Ahkdel/WirelessRobotArm/Photos/IMG_20210429_025416.jpg

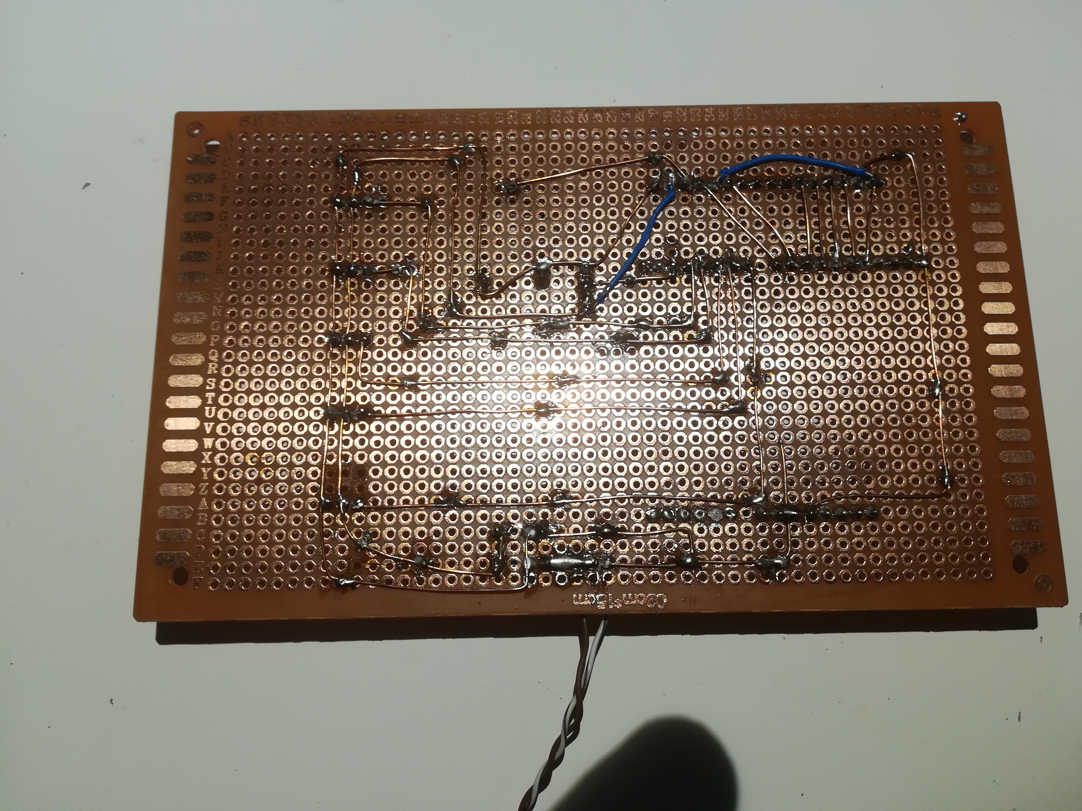
Photos/IMG_20210429_025416.jpg
