Ahkdel/WirelessRobotArm/Robot+Gripper+MG90S+/images/card_preview_gripper_v2.PNG

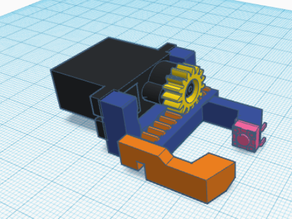
Robot+Gripper+MG90S+/images/card_preview_gripper_v2.PNG
