Ahkdel/WirelessRobotArm/Circuits/receiver circuit.BMP

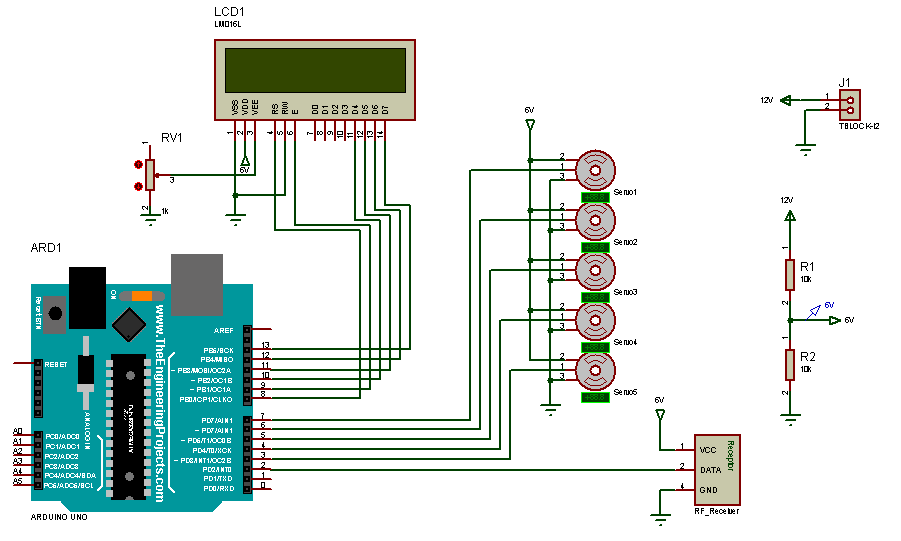
Circuits/receiver circuit.BMP
