Ahkdel/WirelessRobotArm/dan robot arm/images/0ae6d6eee16928dc33c345dd7e37c0fc_preview_featured.jpg

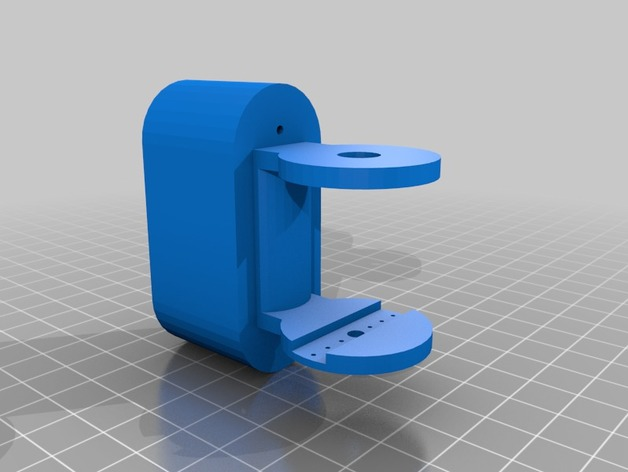
dan robot arm/images/0ae6d6eee16928dc33c345dd7e37c0fc_preview_featured.jpg
