Ahkdel/WirelessRobotArm/dan robot arm/images/57f312213586f4db5ce062b65d8a6737_preview_featured.jpg

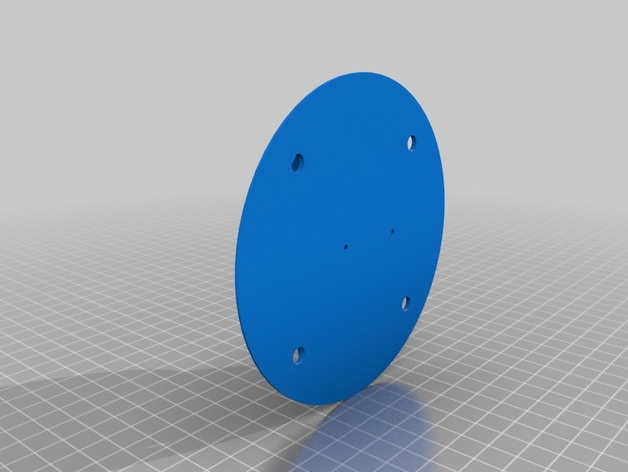
dan robot arm/images/57f312213586f4db5ce062b65d8a6737_preview_featured.jpg
