Ahkdel/WirelessRobotArm/dan robot arm/images/775567f67922da70272757af8e796da0_preview_featured.jpg

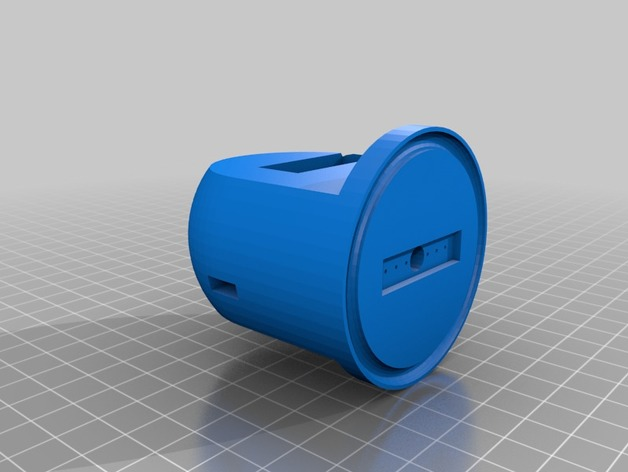
dan robot arm/images/775567f67922da70272757af8e796da0_preview_featured.jpg
