Ahkdel/WirelessRobotArm/dan robot arm/images/b43055eece1fc8d2b7b2e10ad4672d2d_preview_featured.jpg

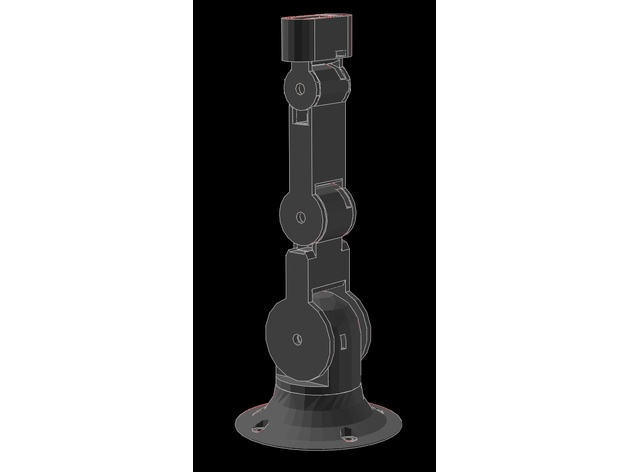
dan robot arm/images/b43055eece1fc8d2b7b2e10ad4672d2d_preview_featured.jpg
