Ahkdel/WirelessRobotArm/Diagramas/Diagrama de bloques3.png

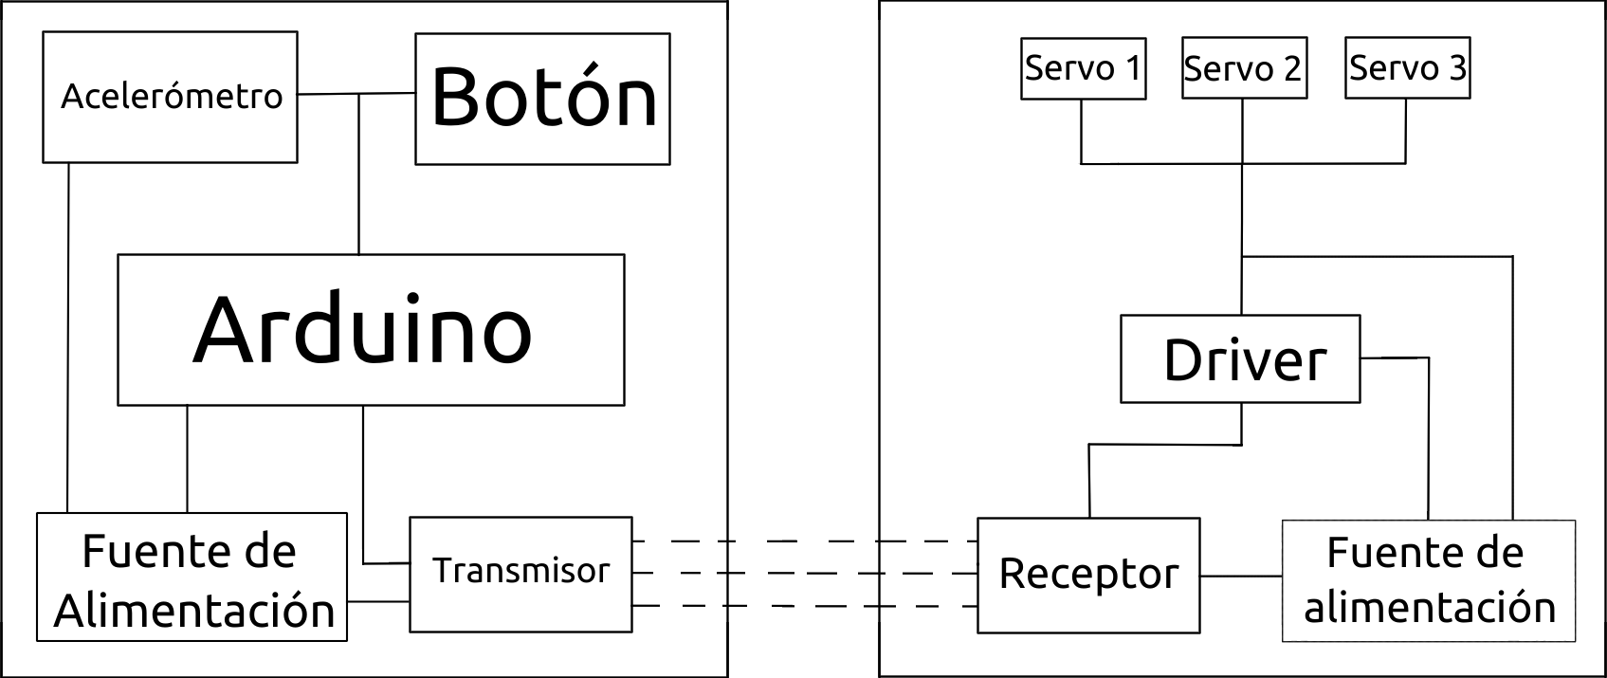
Diagramas/Diagrama de bloques3.png
