Ahkdel/WirelessRobotArm/Diagramas/Diagrama de bloques.png

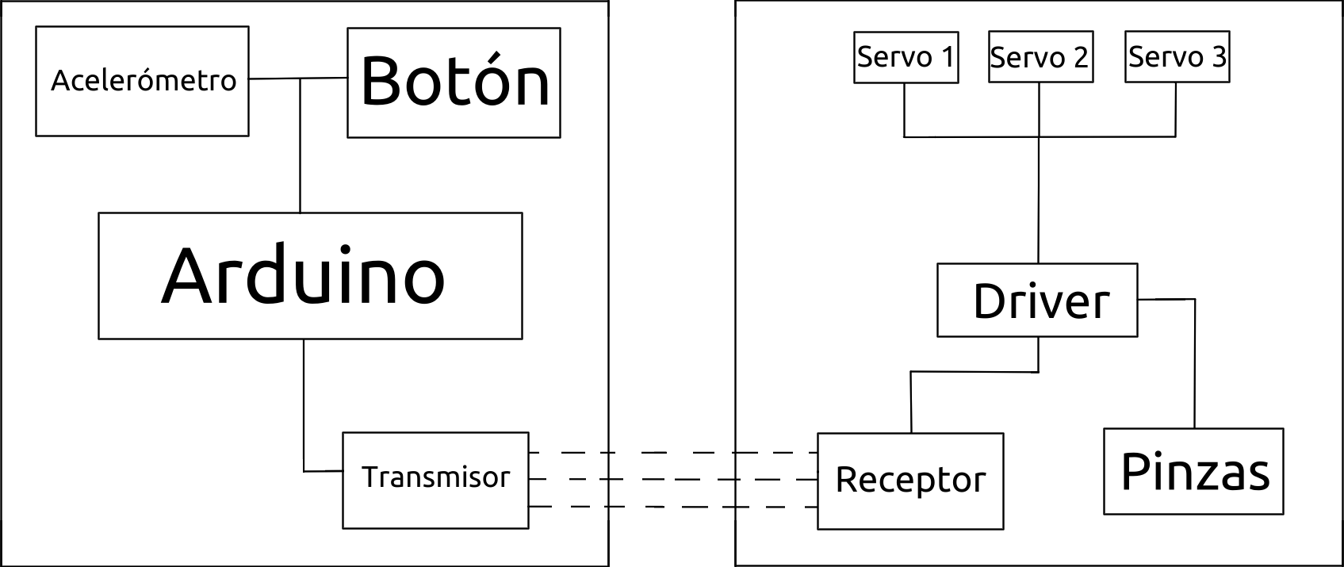
Diagramas/Diagrama de bloques.png
