Ahkdel/WirelessRobotArm/Photos/IMG_20210429_025436.jpg

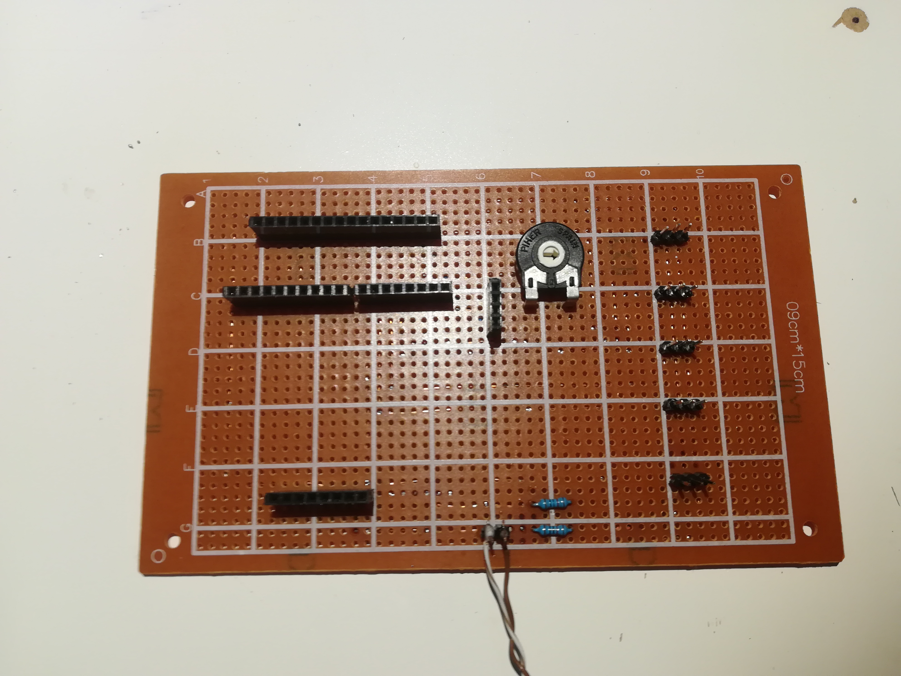
Photos/IMG_20210429_025436.jpg
