Ahkdel/WirelessRobotArm/Photos/IMG_20210430_110134.jpg

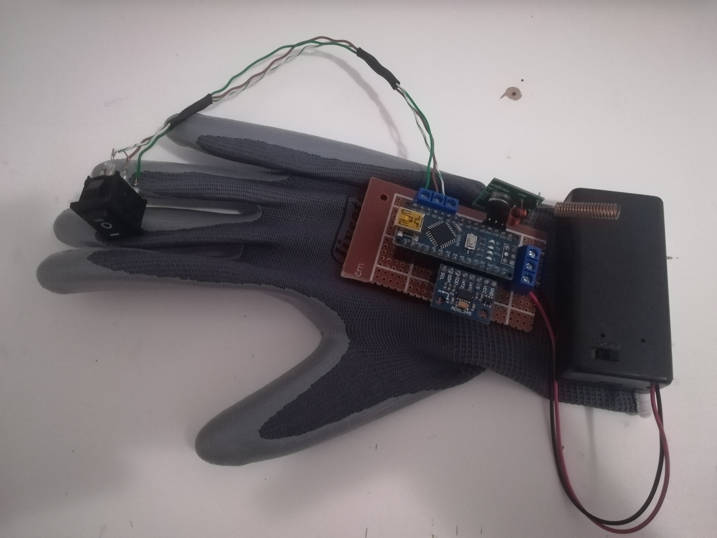
Photos/IMG_20210430_110134.jpg
