Ahkdel/WirelessRobotArm/Photos/IMG_20210430_110211.jpg

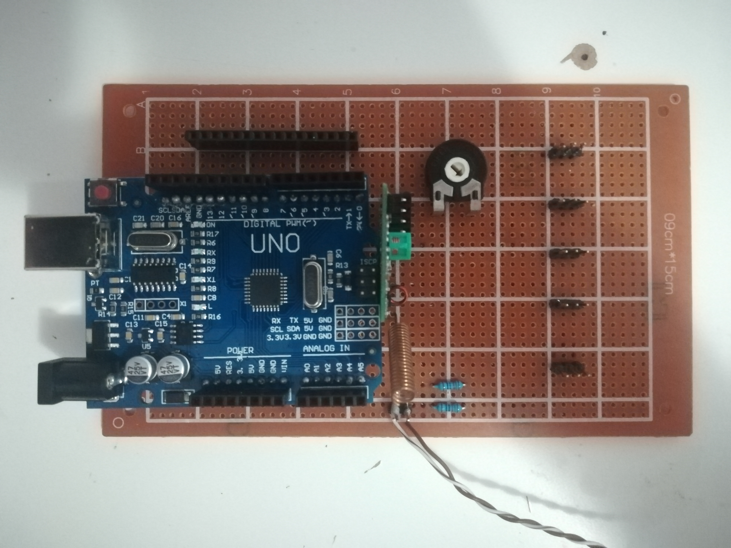
Photos/IMG_20210430_110211.jpg
