Ahkdel/WirelessRobotArm/Photos/IMG_20210430_110328.jpg

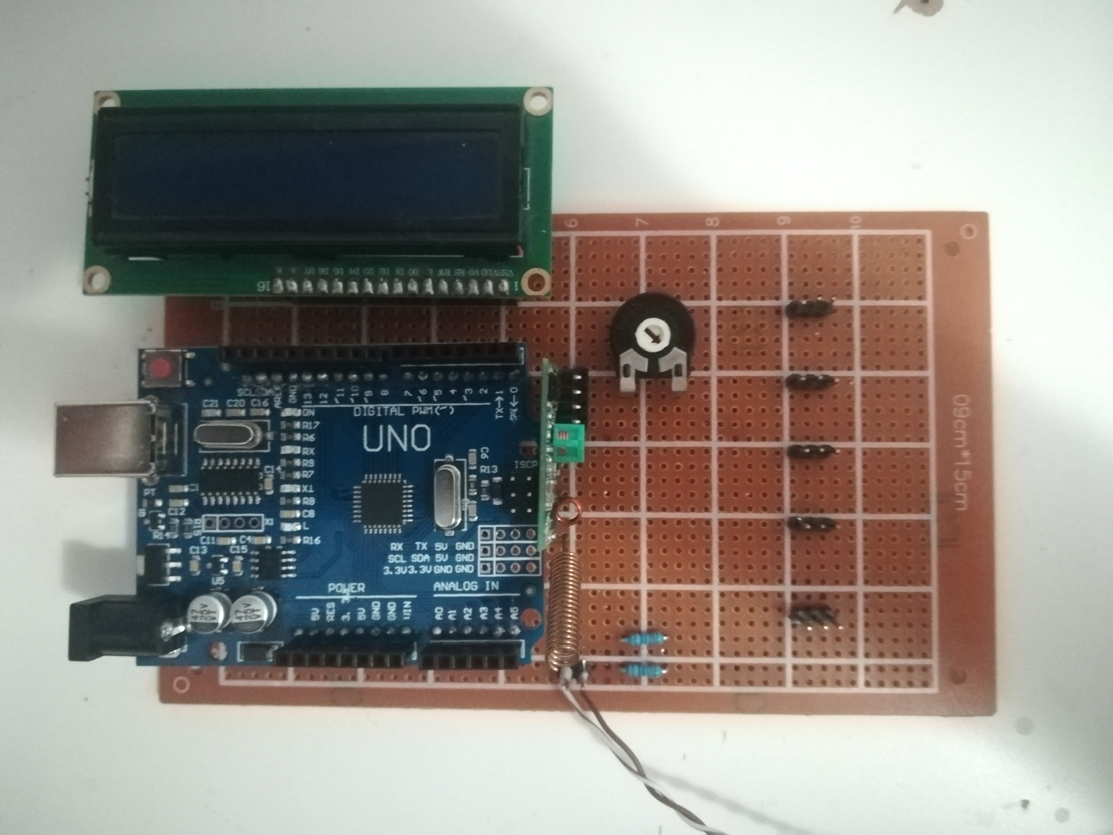
Photos/IMG_20210430_110328.jpg
