Ahkdel/WirelessRobotArm/Photos/IMG_20210430_110356.jpg

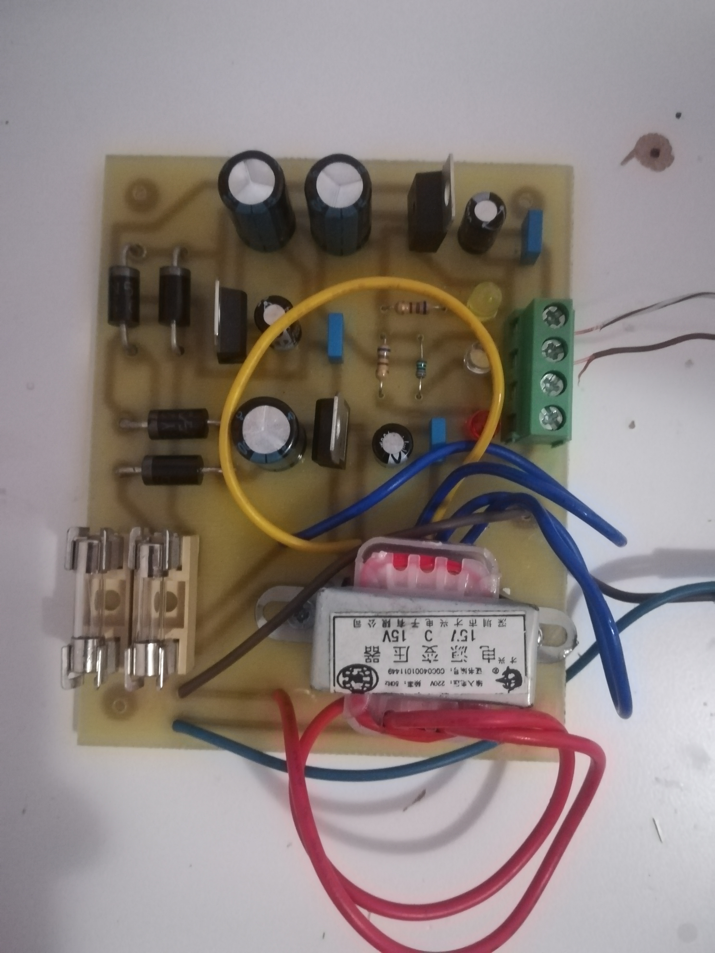
Photos/IMG_20210430_110356.jpg
