Ahkdel/WirelessRobotArm/Photos/IMG_20210430_181212.jpg

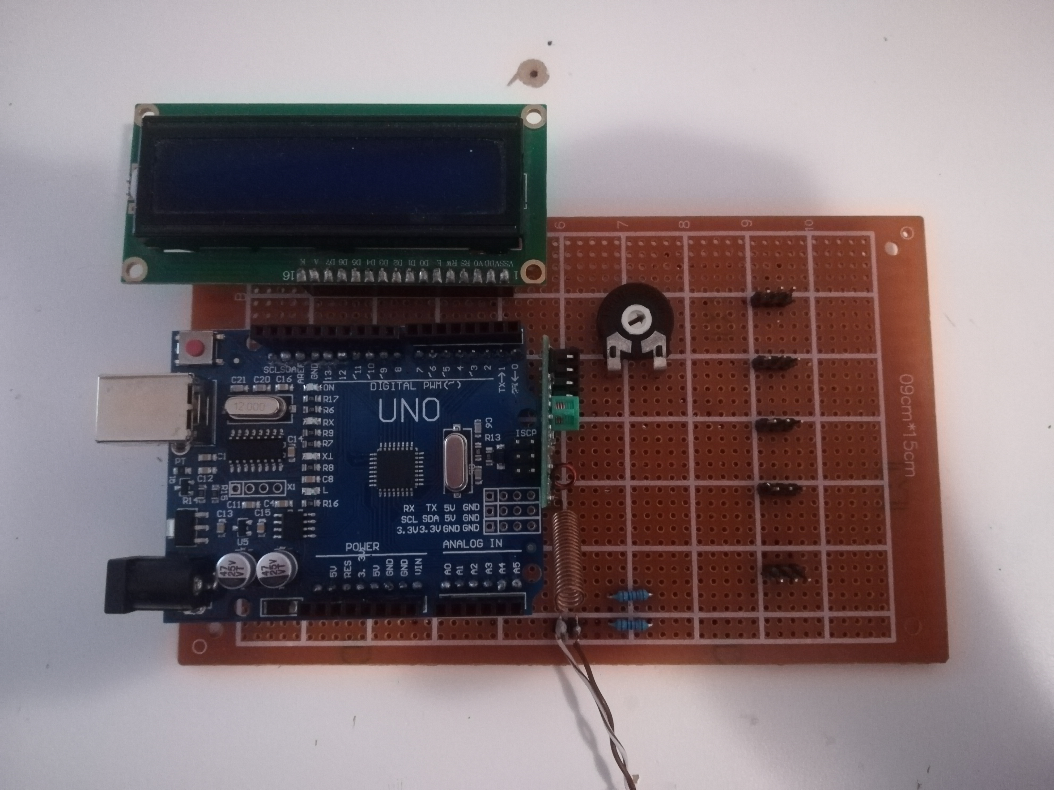
Photos/IMG_20210430_181212.jpg
