Ahkdel/WirelessRobotArm/Photos/IMG_20210430_181712.jpg

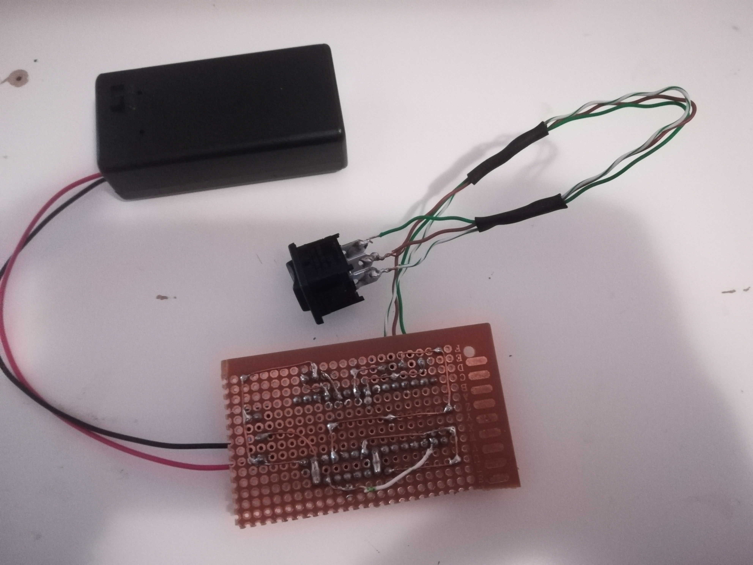
Photos/IMG_20210430_181712.jpg
