Ahkdel/WirelessRobotArm/Photos/IMG_20210430_181934.jpg

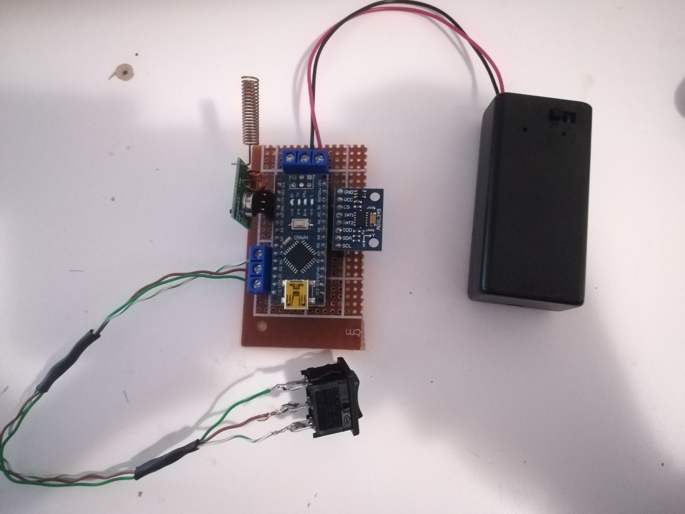
Photos/IMG_20210430_181934.jpg
