Ahkdel/WirelessRobotArm/Photos/IMG_20210430_182728.jpg

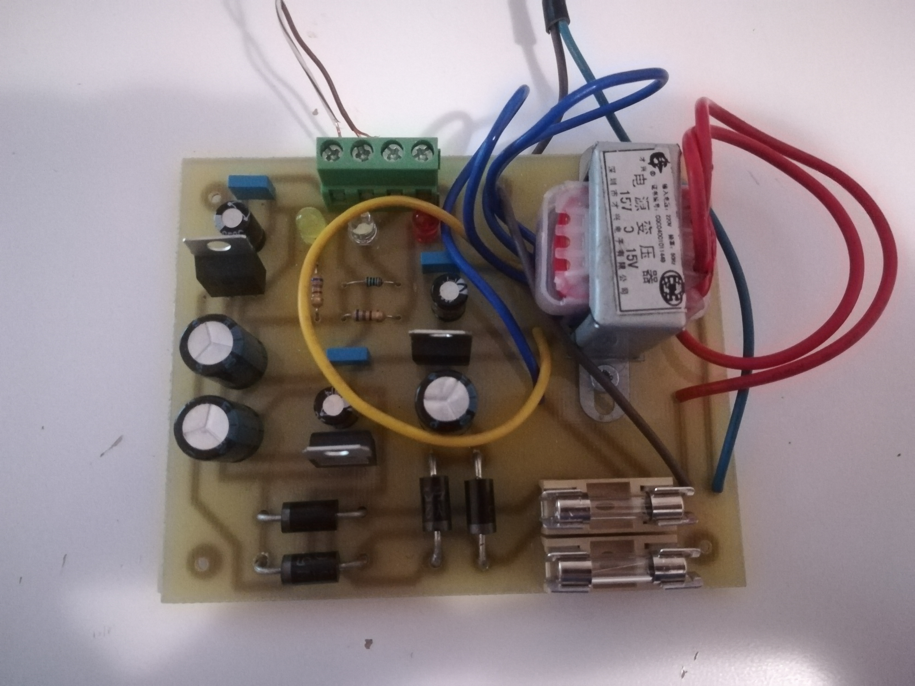
Photos/IMG_20210430_182728.jpg
