Ahkdel/WirelessRobotArm/Photos/IMG_20210430_183803.jpg

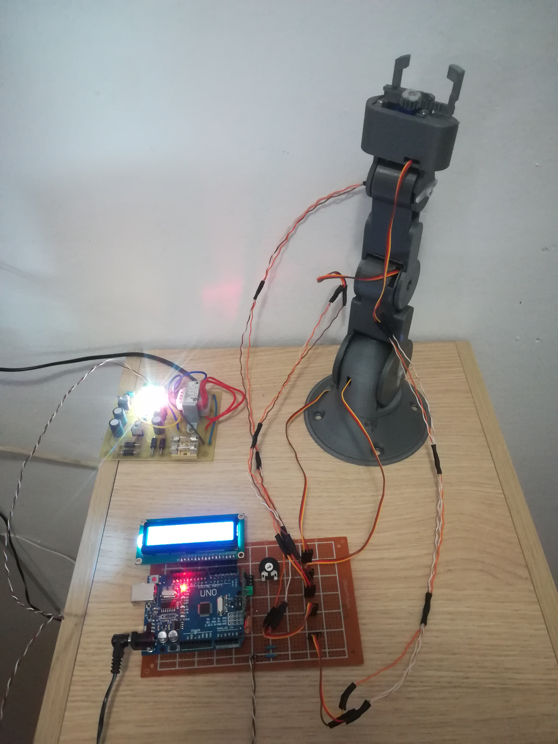
Photos/IMG_20210430_183803.jpg
