Ahkdel/WirelessRobotArm/Photos/IMG_20210430_191755.jpg

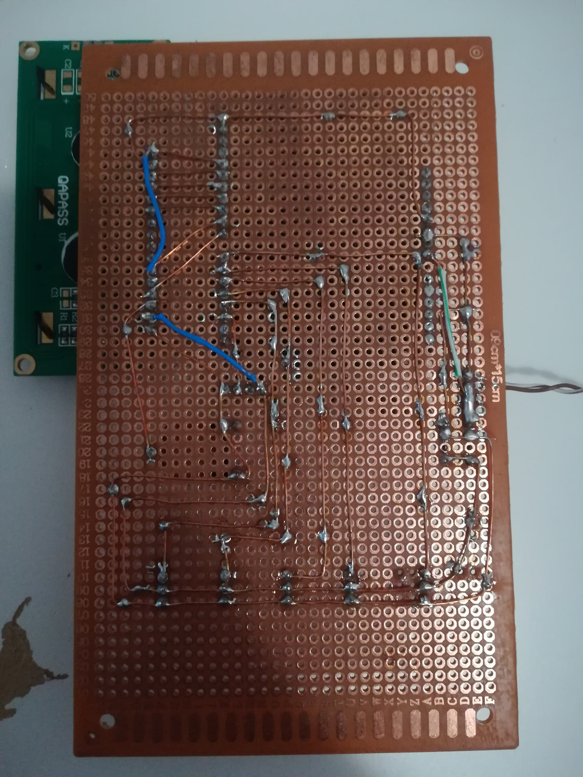
Photos/IMG_20210430_191755.jpg
