Ahkdel/WirelessRobotArm/Photos/Update1/IMG_20210512_164559.jpg

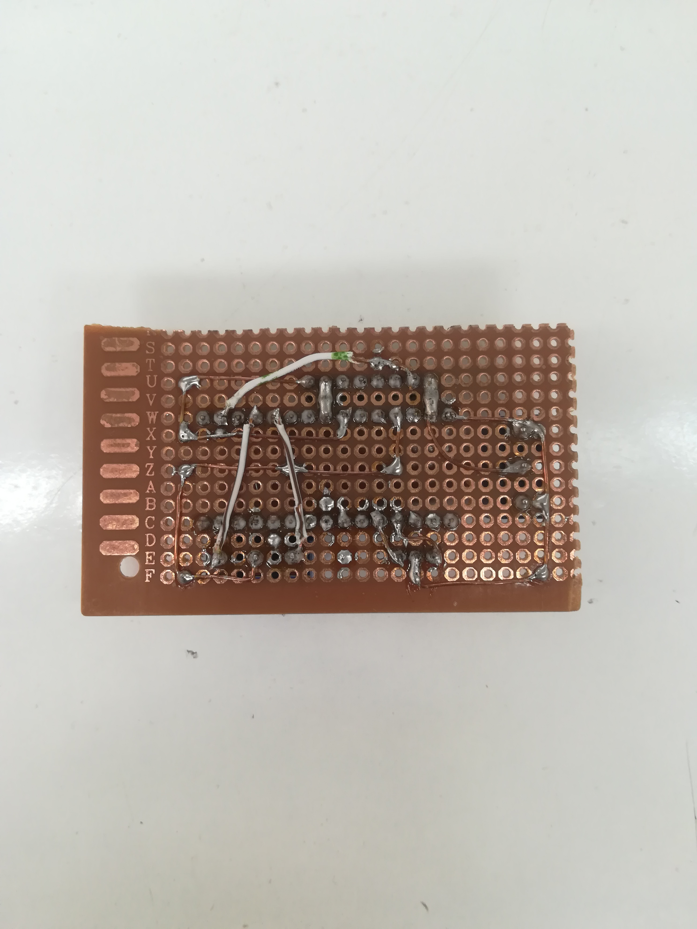
Photos/Update1/IMG_20210512_164559.jpg
