Ahkdel/WirelessRobotArm/Photos/Update1/IMG_20210513_072025.jpg

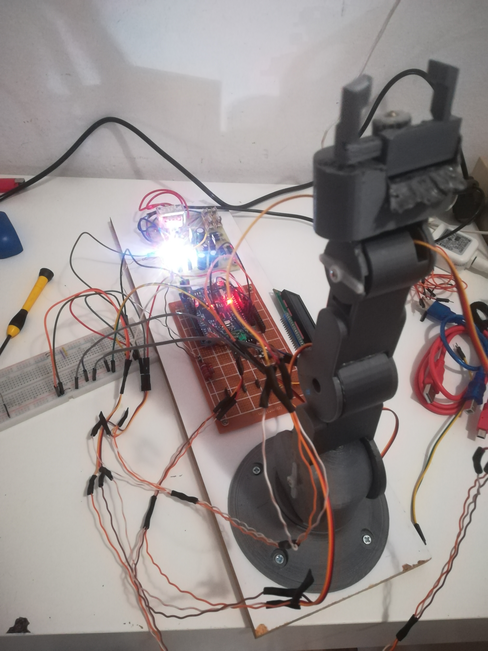
Photos/Update1/IMG_20210513_072025.jpg
