Ahkdel/WirelessRobotArm/Photos/Update1/IMG_20210513_074750.jpg

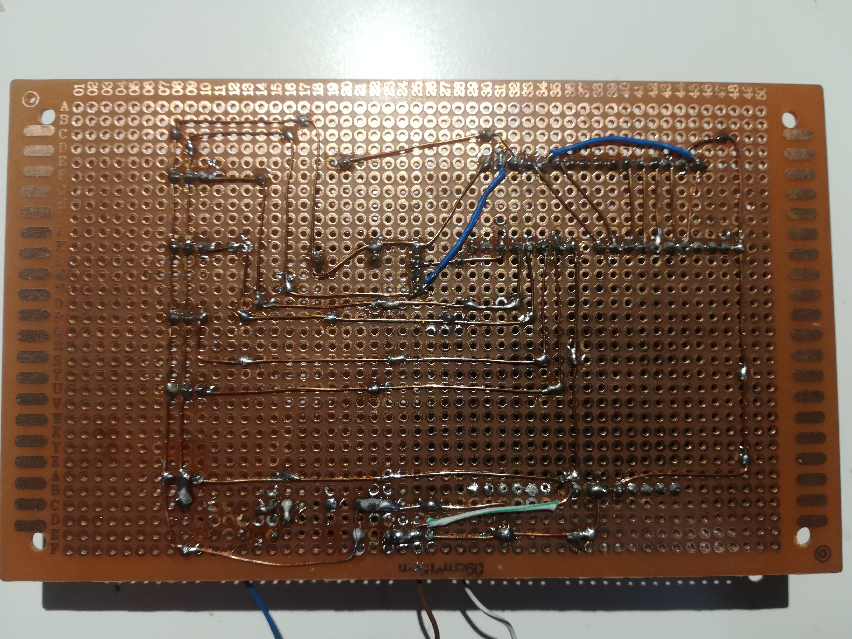
Photos/Update1/IMG_20210513_074750.jpg
