Ahkdel/WirelessRobotArm/Photos/Update1/IMG_20210513_081245.jpg

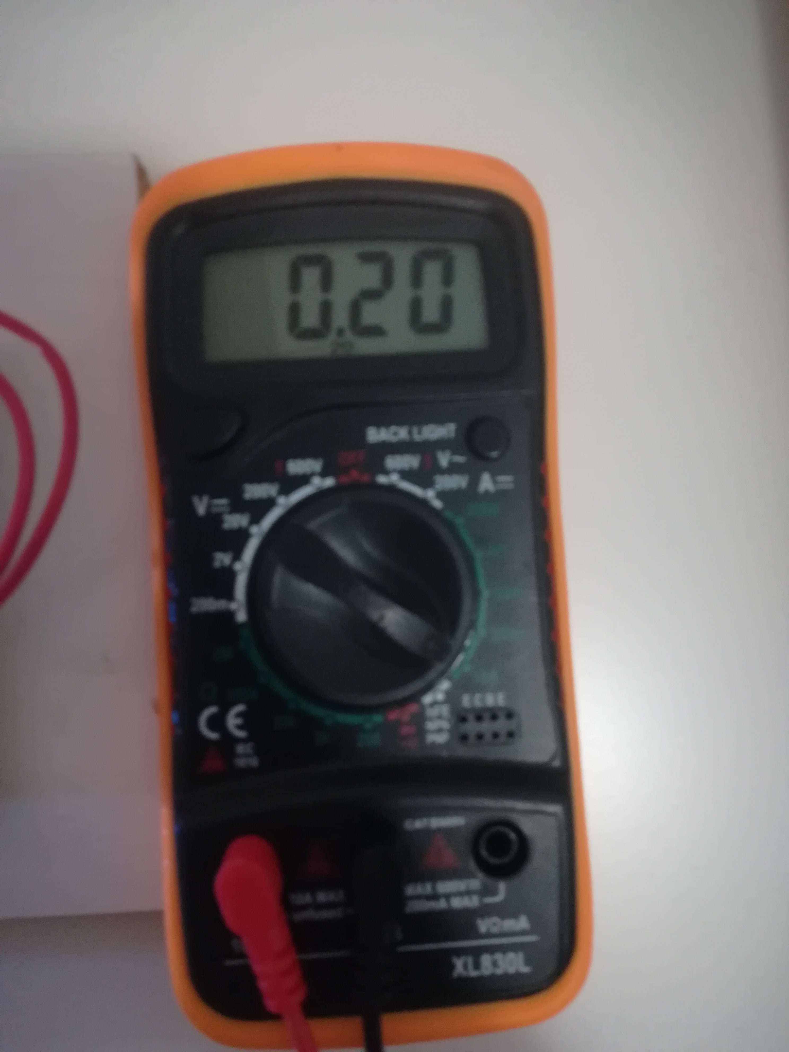
Photos/Update1/IMG_20210513_081245.jpg
