Ahkdel/WirelessRobotArm/Photos/Update1/IMG_20210513_150117.jpg

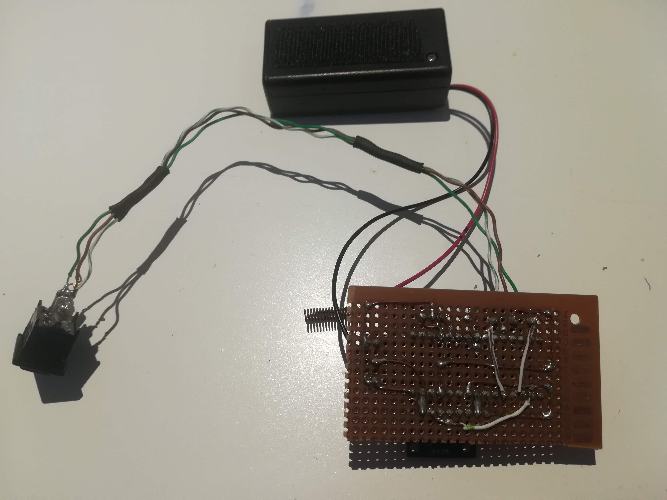
Photos/Update1/IMG_20210513_150117.jpg
