Ahkdel/WirelessRobotArm/Photos/Update1/IMG_20210513_150123.jpg

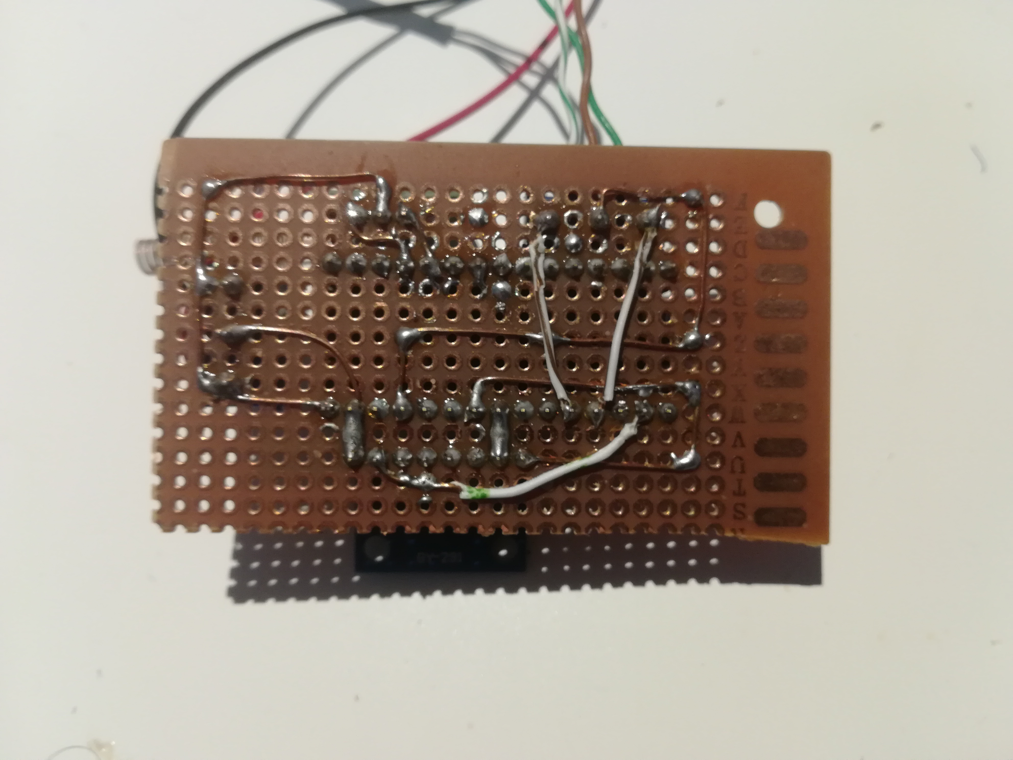
Photos/Update1/IMG_20210513_150123.jpg
