Ahkdel/WirelessRobotArm/references/mg996r.jpg

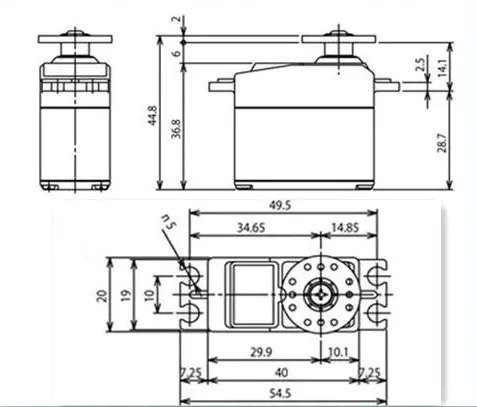
references/mg996r.jpg
