Ahkdel/WirelessRobotArm/references/receiver circuit pcb.BMP

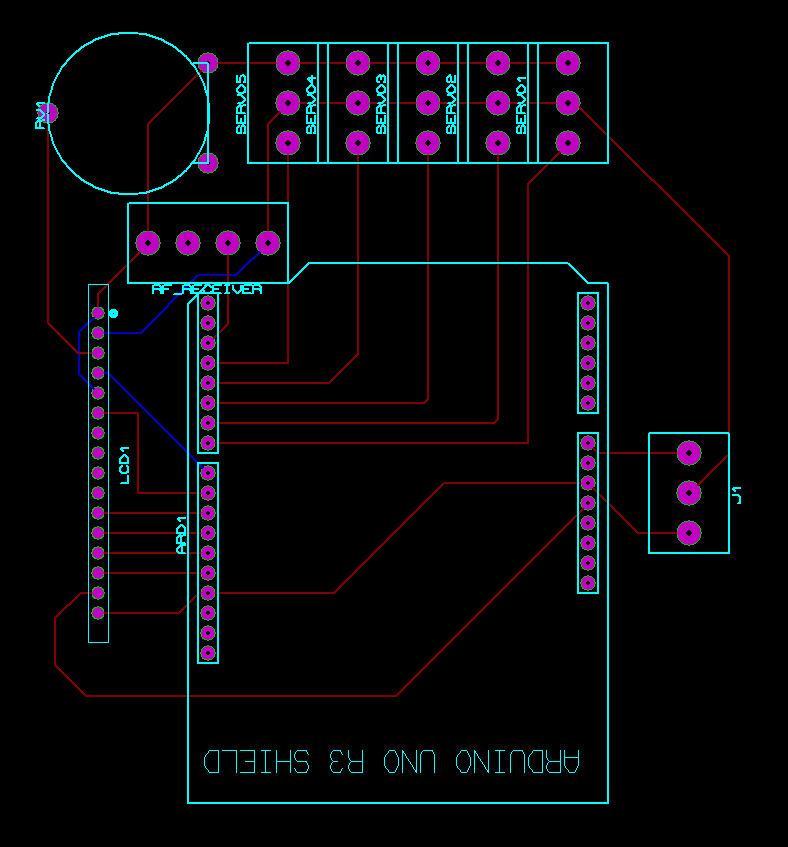
references/receiver circuit pcb.BMP
