Ahkdel/WirelessRobotArm/references/transmitter circuit pcb.BMP

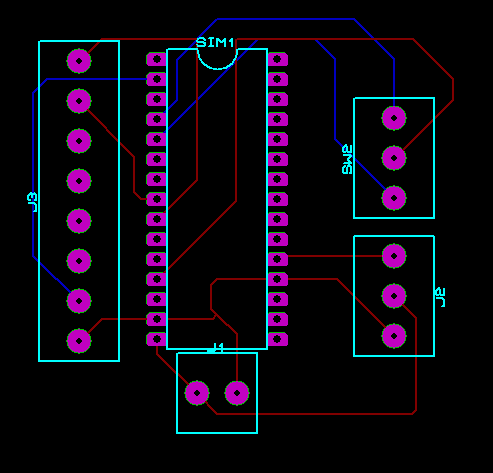
references/transmitter circuit pcb.BMP
