Ahkdel/WirelessRobotArm/references/transmitter circuit.BMP

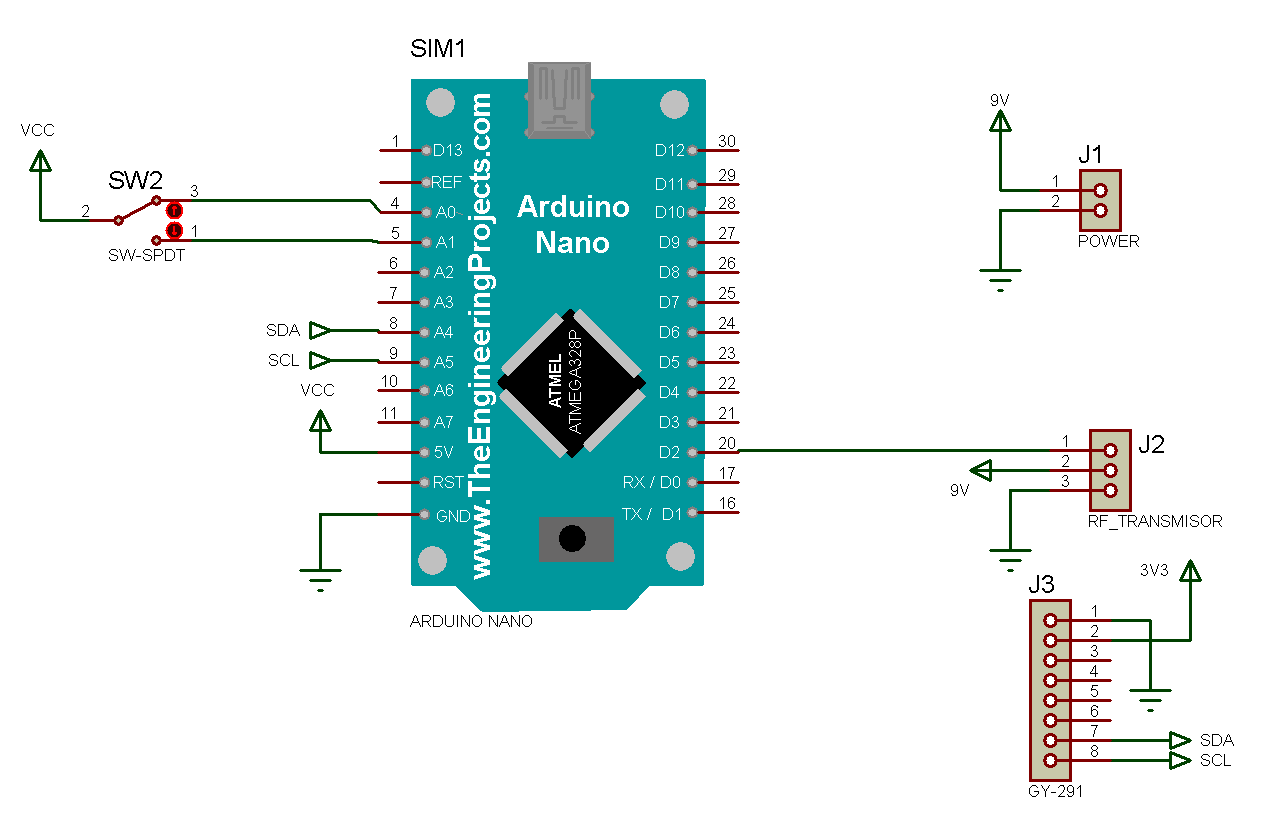
references/transmitter circuit.BMP
