Ahkdel/WirelessRobotArm/Robot+Gripper+MG90S+/images/large_display_IMG_2346[1.JPG

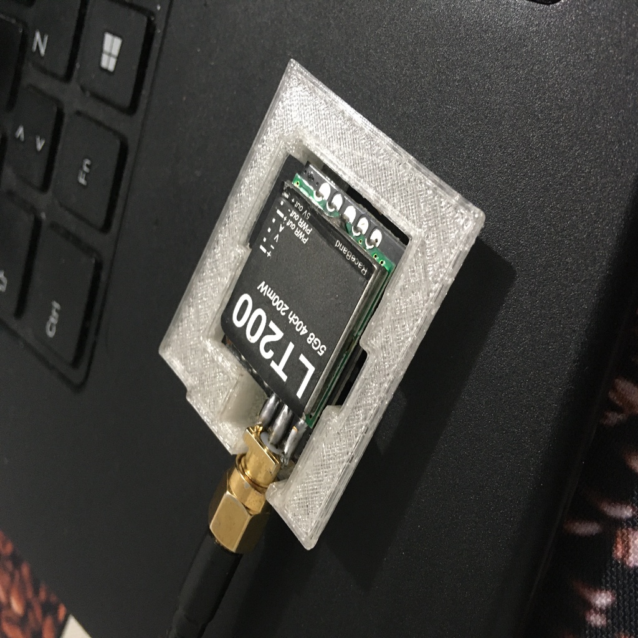
Robot+Gripper+MG90S+/images/large_display_IMG_2346[1.JPG
