Ahkdel/WirelessRobotArm/Robot+Gripper+MG90S+/images/large_display_vg4.png

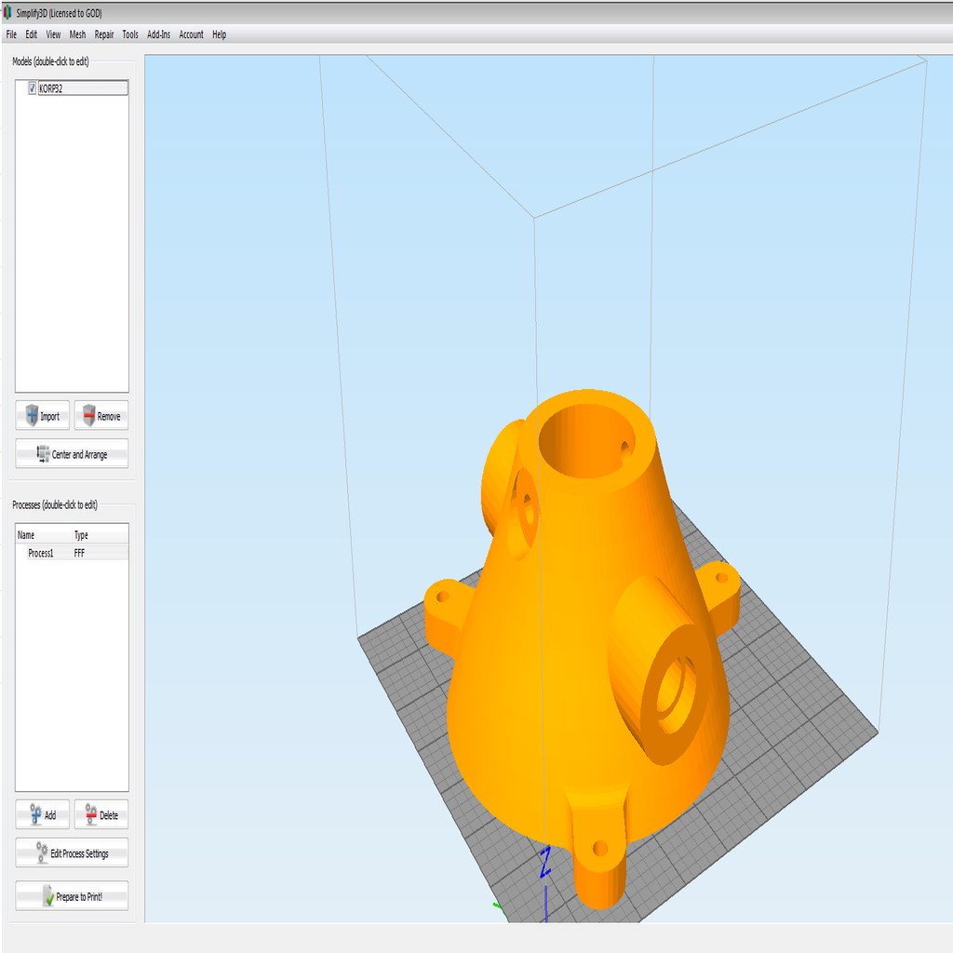
Robot+Gripper+MG90S+/images/large_display_vg4.png
