Ahkdel/WirelessRobotArm/Robot+Gripper+MG90S+/images/small_display_IMG_20190504_113718.jpg

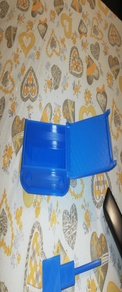
Robot+Gripper+MG90S+/images/small_display_IMG_20190504_113718.jpg
