Ahkdel/WirelessRobotArm/dan robot arm/files/arm-joint-2.stl

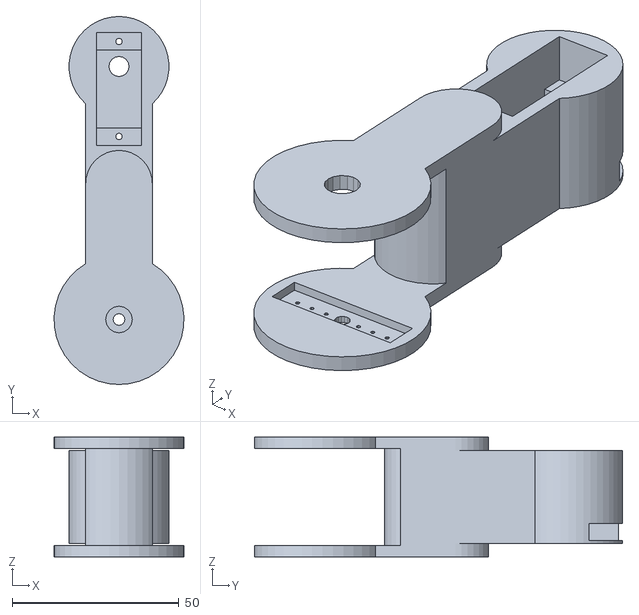
[picture p65: CAD file, 2021-04-09]
dan robot arm/files/arm-joint-2.stl
39.0 x 110.4 x 36.0
