Ahkdel/WirelessRobotArm/dan robot arm/to check/arm-joint-1v1.STL

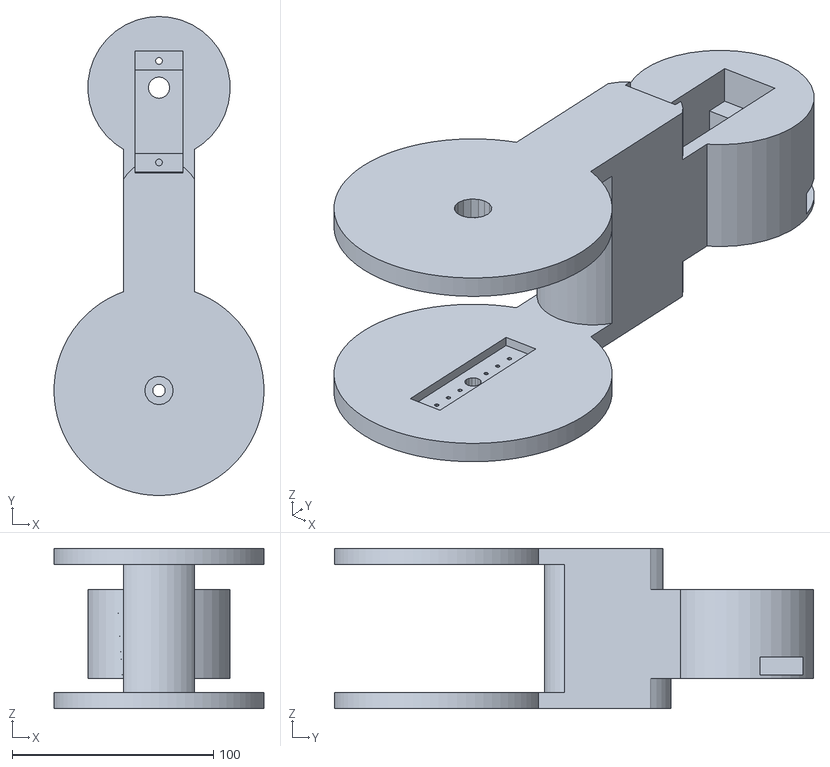
[picture p66: CAD file, 2021-05-12]
dan robot arm/to check/arm-joint-1v1.STL
104.4 x 238.2 x 79.7
