Ahkdel/WirelessRobotArm/dan robot arm/working directory/arm-joint-1v1.FCStd

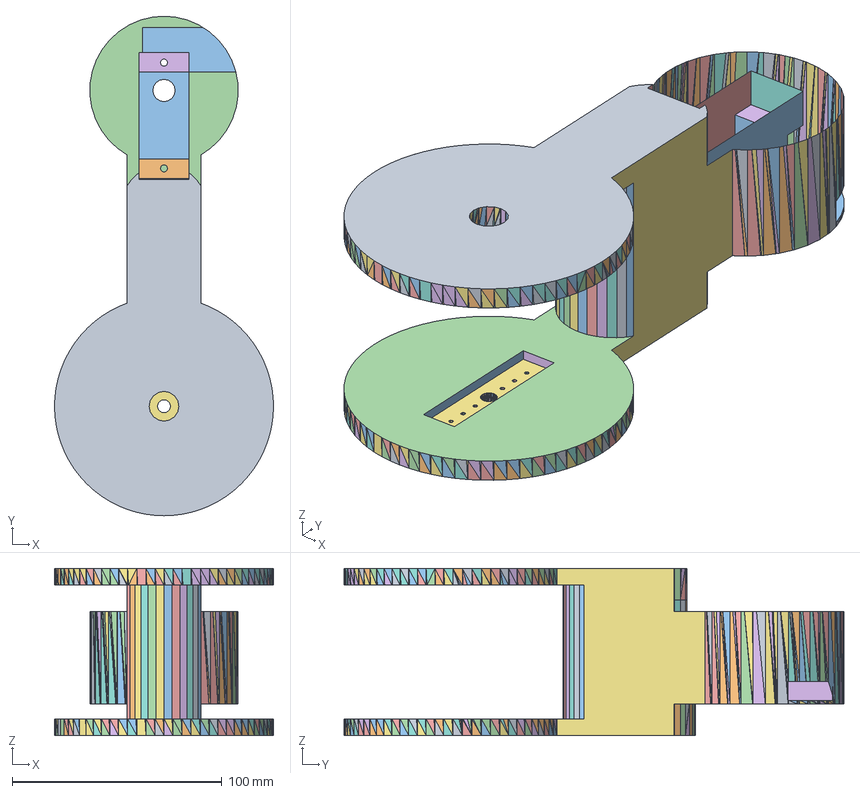
[picture p67: CAD file, 2021-05-12]
dan robot arm/working directory/arm-joint-1v1.FCStd
104.4 x 238.2 x 79.7 mm
Ruled_Surface031
Ruled_Surface032
Ruled_Surface033
Ruled_Surface034
Ruled_Surface035
Ruled_Surface036
Ruled_Surface037
Ruled_Surface038
Ruled_Surface039
Ruled_Surface040
Ruled_Surface041
Ruled_Surface042
Ruled_Surface043
Ruled_Surface044
Ruled_Surface045
Ruled_Surface046
Ruled_Surface047
Ruled_Surface048
Ruled_Surface049
Ruled_Surface050
Ruled_Surface051
Ruled_Surface052
Ruled_Surface053
Ruled_Surface054
Ruled_Surface055
Ruled_Surface056
Ruled_Surface057
Ruled_Surface058
Ruled_Surface059
Ruled_Surface060
Ruled_Surface061
