Ahkdel/WirelessRobotArm/Robot+Gripper+MG90S+/files/gripper_rack-gear_v3.SLDPRT

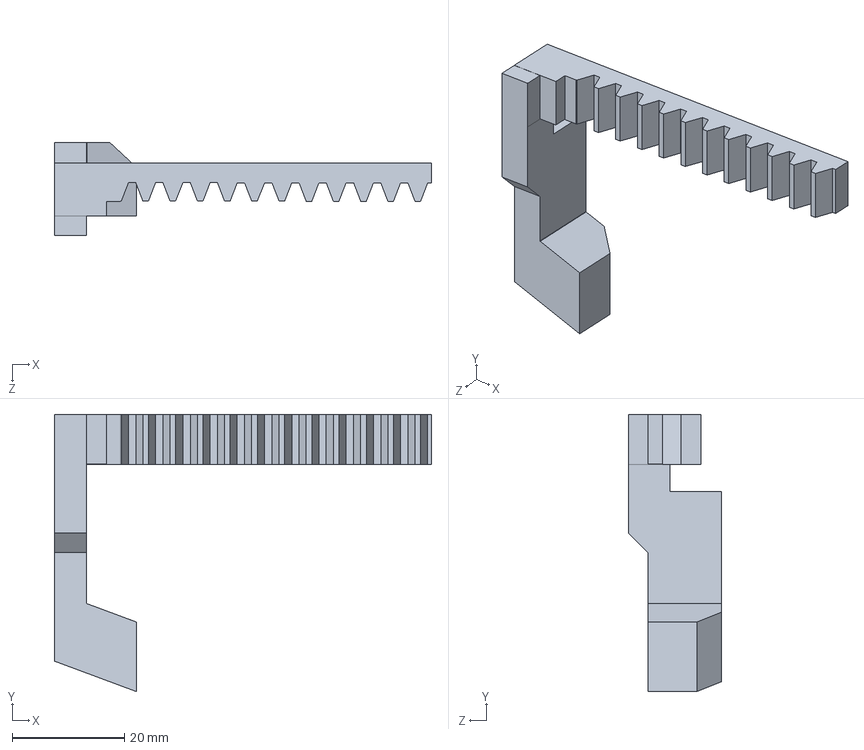
[picture p68: CAD file, 2021-04-09]
Robot+Gripper+MG90S+/files/gripper_rack-gear_v3.SLDPRT
67.2 x 49.4 x 16.6 mm
