Ahkdel/WirelessRobotArm/Robot+Gripper+MG90S+/to print/gripper_rack-gear_v3.stl

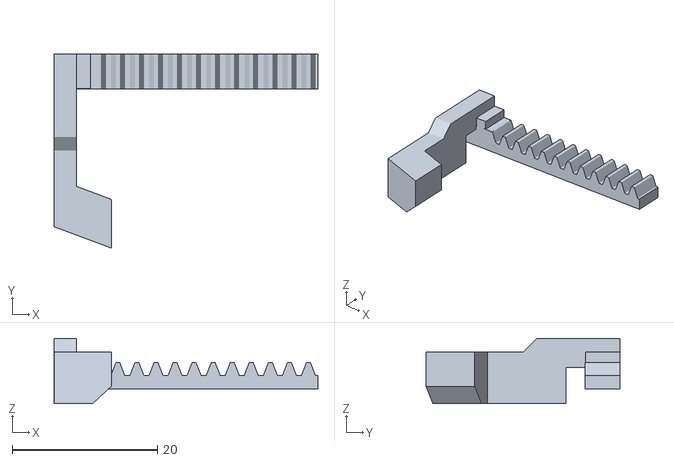
[picture p69: CAD file, 2021-04-09]
Robot+Gripper+MG90S+/to print/gripper_rack-gear_v3.stl
36.3 x 26.7 x 9.00
