Ahkdel/WirelessRobotArm/dan robot arm/arm-joint-3/arm-joint-3-1.stl

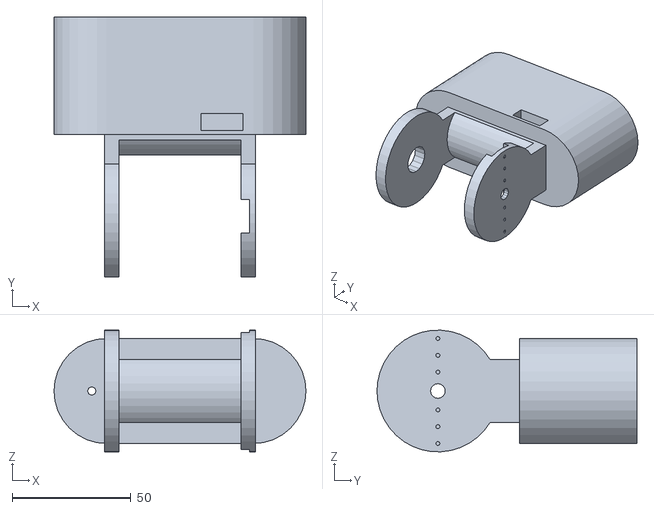
[picture p70: CAD file, 2021-04-09]
dan robot arm/arm-joint-3/arm-joint-3-1.stl
106.2 x 109.6 x 51.3
