Ahkdel/WirelessRobotArm/dan robot arm/files/base-joint.stl

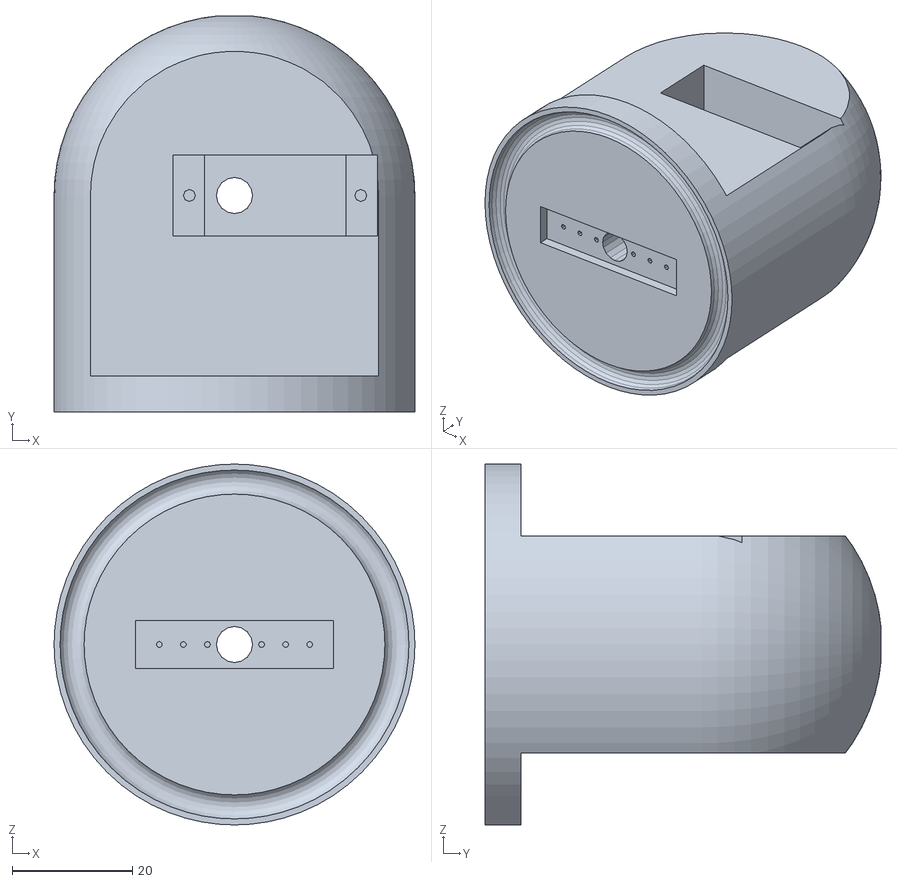
[picture p71: CAD file, 2021-04-09]
dan robot arm/files/base-joint.stl
60.0 x 65.8 x 60.0
