Ahkdel/WirelessRobotArm/Robot+Gripper+MG90S+/files/gripper_base_v2.SLDPRT

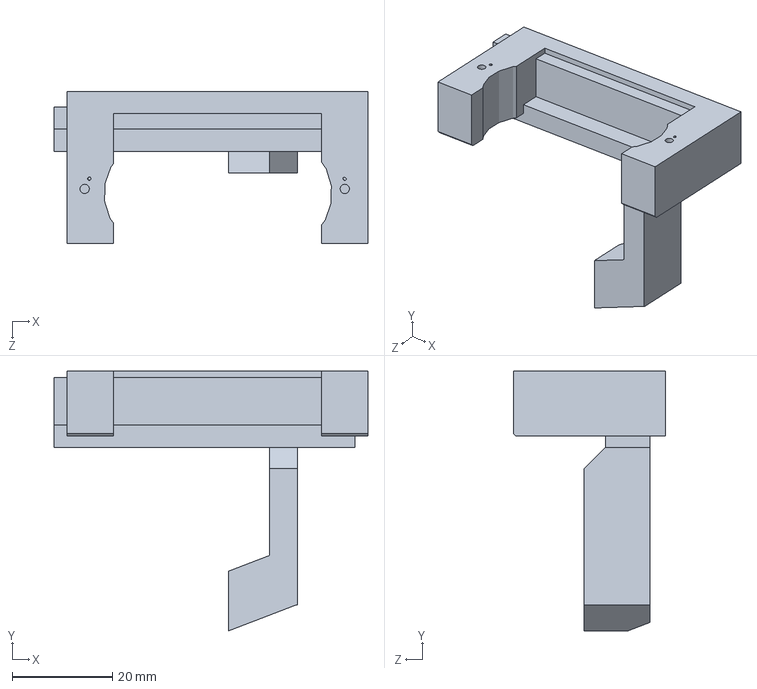
[picture p72: CAD file, 2021-04-09]
Robot+Gripper+MG90S+/files/gripper_base_v2.SLDPRT
62.5 x 51.8 x 30.3 mm
