Ahkdel/WirelessRobotArm/Robot+Gripper+MG90S+/to print/gripper_base_v2.stl

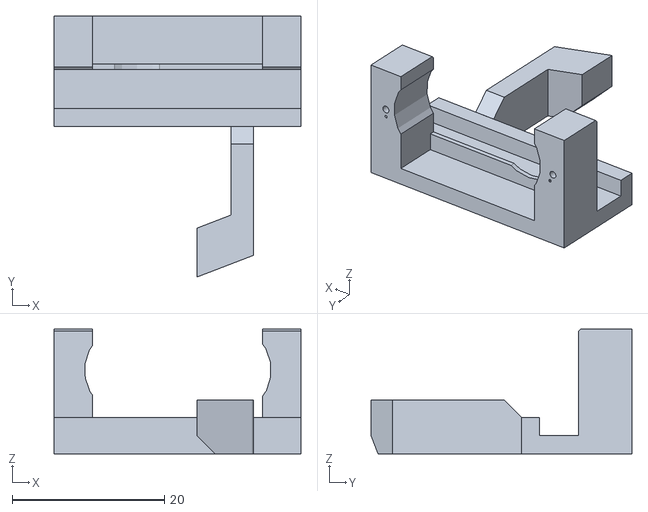
[picture p73: CAD file, 2021-04-09]
Robot+Gripper+MG90S+/to print/gripper_base_v2.stl
32.4 x 34.3 x 16.4
