Ahkdel/WirelessRobotArm/ToPrint/base1.STL

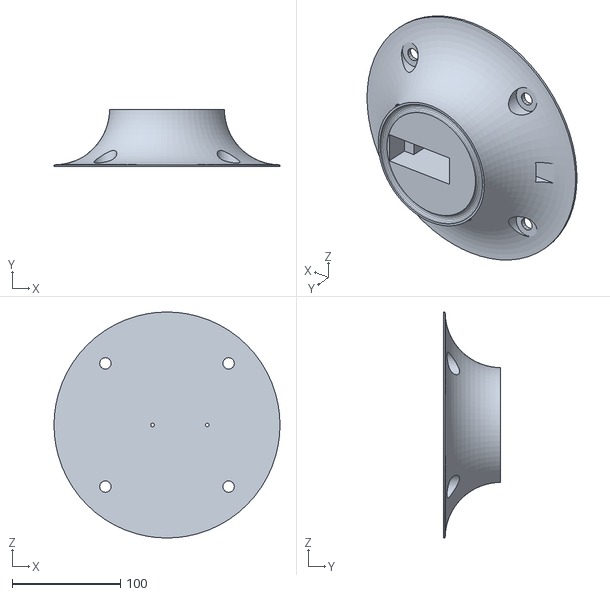
[picture p74: CAD file, 2021-04-09]
ToPrint/base1.STL
208.9 x 53.1 x 208.9
