Ahkdel/WirelessRobotArm/dan robot arm/arm-joint-3/arm-joint-3-v2.stl

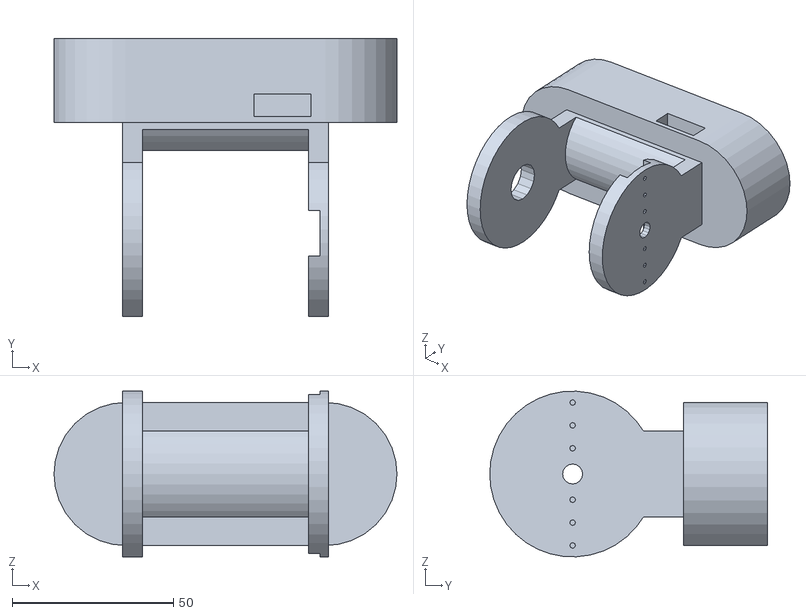
[picture p75: CAD file, 2021-04-09]
dan robot arm/arm-joint-3/arm-joint-3-v2.stl
106.2 x 85.9 x 51.3
