Ahkdel/WirelessRobotArm/dan robot arm/files/arm-joint-3.stl

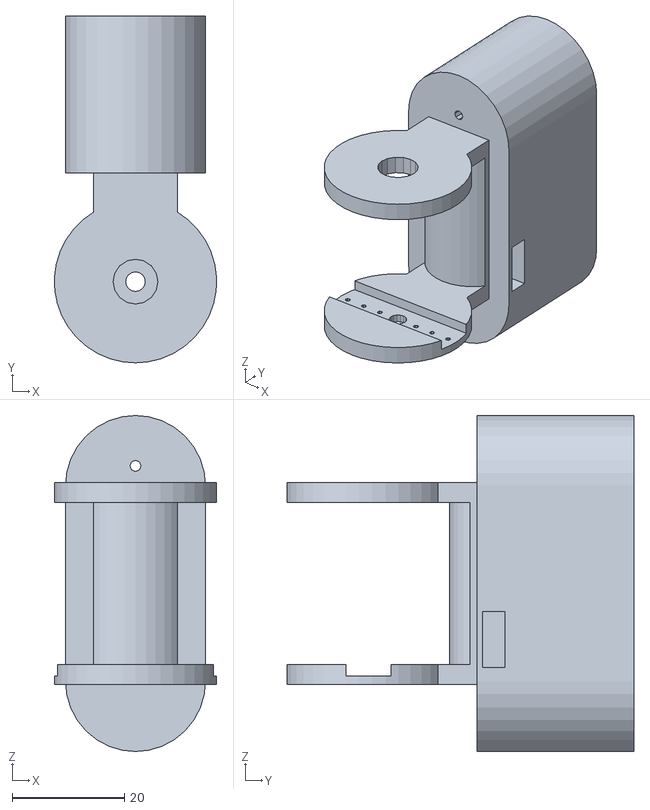
[picture p76: CAD file, 2021-04-09]
dan robot arm/files/arm-joint-3.stl
29.0 x 61.9 x 60.0
