Ahkdel/WirelessRobotArm/Robot+Gripper+MG90S+/files/MG-90s_servo.stl

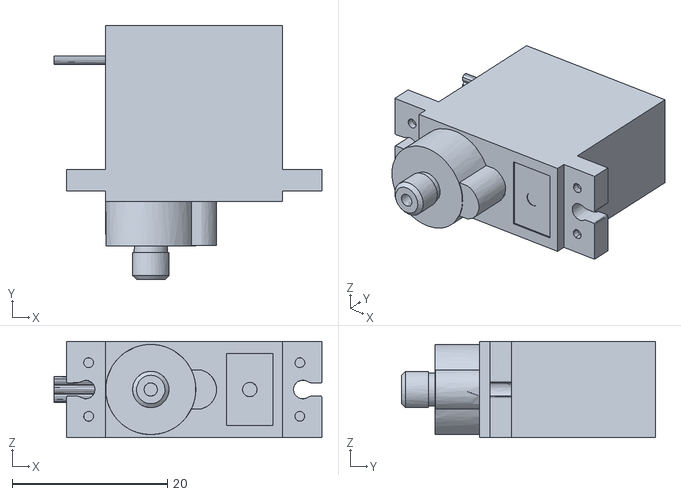
[picture p77: CAD file, 2021-04-09]
Robot+Gripper+MG90S+/files/MG-90s_servo.stl
34.5 x 32.7 x 12.4
