Ahkdel/WirelessRobotArm/Robot+Gripper+MG90S+/to print/gear.stl

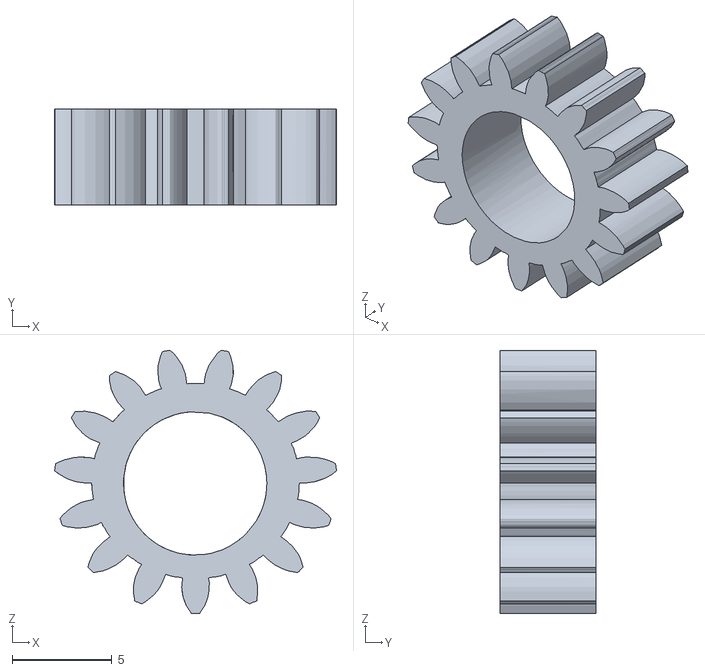
[picture p78: CAD file, 2021-04-09]
Robot+Gripper+MG90S+/to print/gear.stl
14.2 x 4.80 x 13.2
