Ahkdel/WirelessRobotArm/dan robot arm/files/base.stl

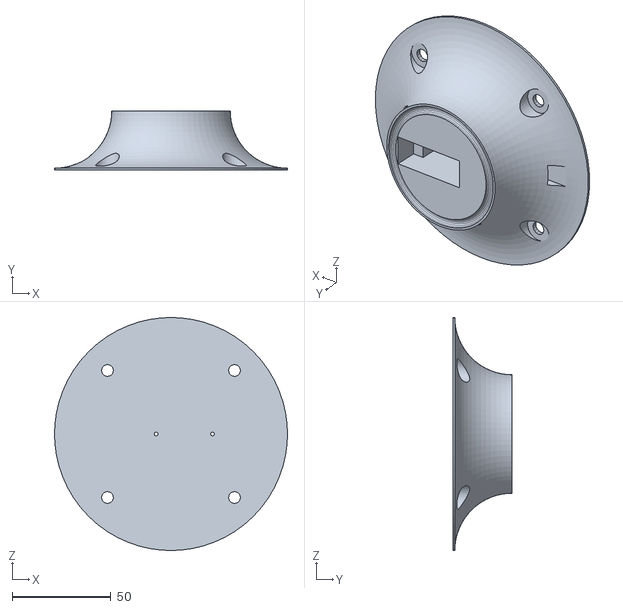
[picture p79: CAD file, 2021-04-09]
dan robot arm/files/base.stl
118.0 x 30.0 x 118.0
