Ahkdel/WirelessRobotArm/dan robot arm/working directory/arm-joint-2-1.STL

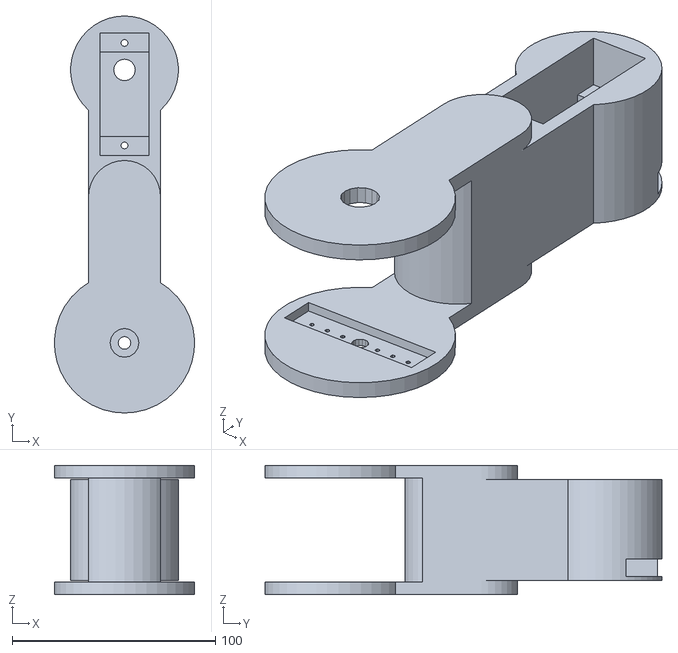
[picture p80: CAD file, 2021-04-09]
dan robot arm/working directory/arm-joint-2-1.STL
69.0 x 195.4 x 63.7
