Ahkdel/WirelessRobotArm/Robot+Gripper+MG90S+/files/gear.SLDPRT

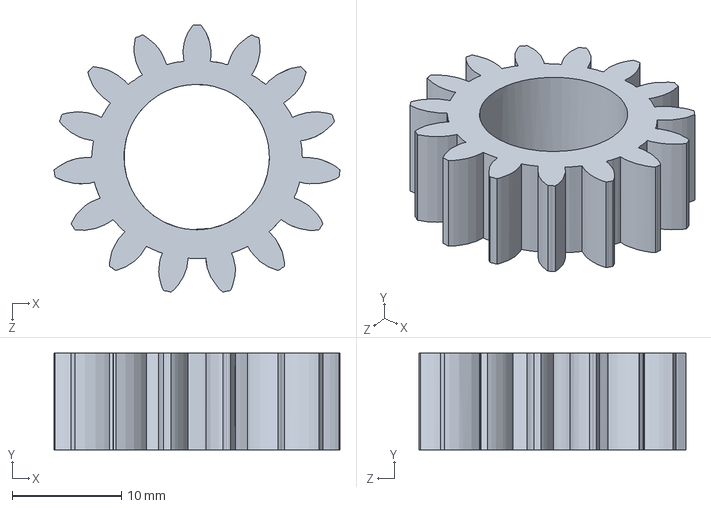
[picture p81: CAD file, 2021-04-09]
Robot+Gripper+MG90S+/files/gear.SLDPRT
26.2 x 8.88 x 24.5 mm
