Ahkdel/WirelessRobotArm/dan robot arm/files/arm-joint.stl

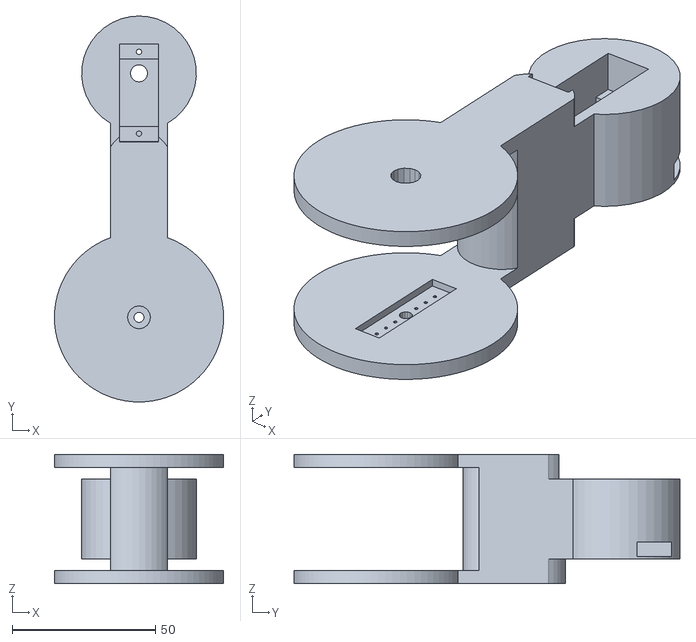
[picture p82: CAD file, 2021-04-09]
dan robot arm/files/arm-joint.stl
59.0 x 134.6 x 45.0
