Ahkdel/WirelessRobotArm/ToPrint/base-joint1.STL

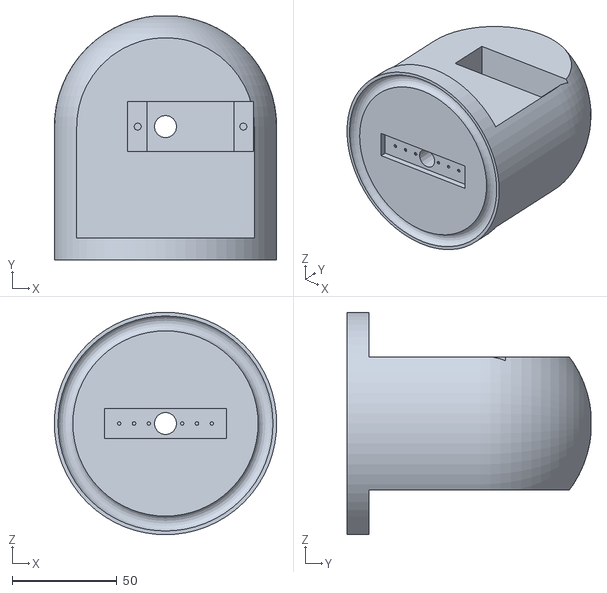
[picture p83: CAD file, 2021-04-09]
ToPrint/base-joint1.STL
106.2 x 116.5 x 106.2
