Ahkdel/WirelessRobotArm/dan robot arm/working directory/arm-joint1.SLDPRT

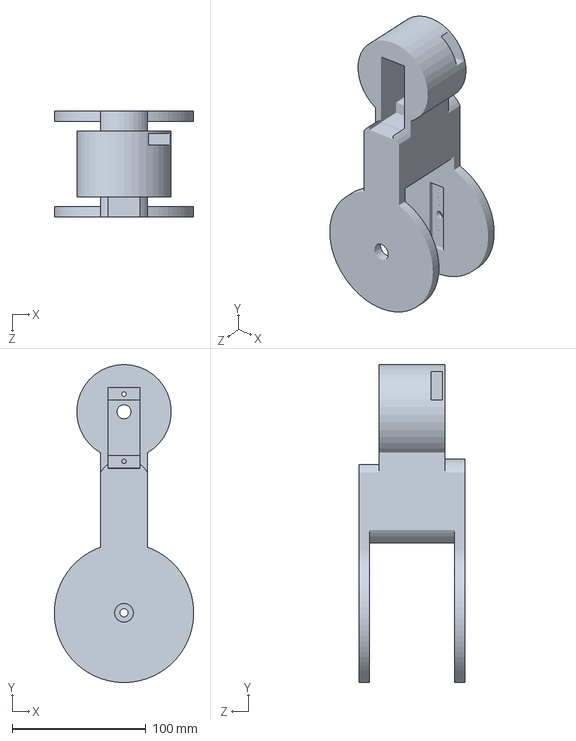
[picture p84: CAD file, 2021-04-09]
dan robot arm/working directory/arm-joint1.SLDPRT
104.4 x 238.2 x 79.7 mm
