Ahkdel/WirelessRobotArm/(list of files, cad)

Other CAD files:
Robot+Gripper+MG90S+/images/large_thumb_gear.stl
ToPrint/gripper_rack-gear_v3.STL
dan robot arm/working directory/arm-joint-3.SLDPRT
Robot+Gripper+MG90S+/images/medium_thumb_gripper_base_v2.stl
Robot+Gripper+MG90S+/images/tiny_thumb_gripper_rack-gear_v3.stl
ToPrint/gripper_base_v2.STL
dan robot arm/working directory/arm-joint-2.SLDPRT
Robot+Gripper+MG90S+/images/medium_thumb_gripper_rack-gear_v3.stl
Robot+Gripper+MG90S+/images/tiny_preview_MG-90s_servo.stl
ToPrint/arm-joint-3-1.STL
Robot+Gripper+MG90S+/images/medium_preview_gear.stl
ToPrint/gear.STL
dan robot arm/working directory/base.SLDPRT
Robot+Gripper+MG90S+/images/large_preview_gripper_base_v2.stl
ToPrint/arm-joint1-1.STL
dan robot arm/working directory/arm-joint.SLDPRT
dan robot arm/working directory/base-joint.SLDPRT
Robot+Gripper+MG90S+/images/tinycard_preview_gripper_base_v2.stl
dan robot arm/working directory/arm-joint1-1.STL
dan robot arm/working directory/arm-joint-3-1.STL
Robot+Gripper+MG90S+/images/tiny_thumb_MG-90s_servo.stl
Robot+Gripper+MG90S+/images/large_preview_gripper_rack-gear_v3.stl
Robot+Gripper+MG90S+/images/tiny_preview_gripper_rack-gear_v3.stl
Robot+Gripper+MG90S+/images/small_display_sign_v1-0c_SingleColor_border20191021-51-12za4wi.stl
Robot+Gripper+MG90S+/images/small_preview_gripper_rack-gear_v3.stl
Robot+Gripper+MG90S+/images/card_preview_gripper_rack-gear_v3.stl
Robot+Gripper+MG90S+/images/tinycard_preview_gripper_rack-gear_v3.stl
Robot+Gripper+MG90S+/images/large_thumb_MG-90s_servo.stl
Robot+Gripper+MG90S+/images/card_preview_gripper_base_v2.stl
Robot+Gripper+MG90S+/images/large_display_container_v1_8_1_lid_double_knurled_20191020-63-1vzpqn0.stl
Robot+Gripper+MG90S+/images/small_thumb_gripper_base_v2.stl
Robot+Gripper+MG90S+/images/large_preview_MG-90s_servo.stl
Robot+Gripper+MG90S+/images/small_preview_gripper_base_v2.stl
Robot+Gripper+MG90S+/images/medium_thumb_gear.stl
Robot+Gripper+MG90S+/images/medium_thumb_MG-90s_servo.stl
Robot+Gripper+MG90S+/images/small_preview_MG-90s_servo.stl
Robot+Gripper+MG90S+/images/small_display_Hinge_no_holes.stl
Robot+Gripper+MG90S+/images/medium_preview_gripper_base_v2.stl
Robot+Gripper+MG90S+/images/large_display_parametric_butt_hinge_3-5-2_20191020-57-1p7u7s8.stl
Robot+Gripper+MG90S+/images/tinycard_preview_MG-90s_servo.stl
Robot+Gripper+MG90S+/images/medium_preview_MG-90s_servo.stl
Robot+Gripper+MG90S+/images/small_thumb_gear.stl
Robot+Gripper+MG90S+/images/tinycard_preview_gear.stl
Robot+Gripper+MG90S+/images/small_preview_gear.stl
Robot+Gripper+MG90S+/images/tiny_preview_gripper_base_v2.stl
Robot+Gripper+MG90S+/images/large_display_Supporto_sonda_pt2.stl
Robot+Gripper+MG90S+/images/large_thumb_gripper_rack-gear_v3.stl
Robot+Gripper+MG90S+/images/large_display_dogtag_customizer_20191021-51-d8i4lj.stl
Robot+Gripper+MG90S+/images/large_thumb_gripper_base_v2.stl
Robot+Gripper+MG90S+/images/small_display_sign_v1-0c_SingleColor_base20191021-51-1lgl532.stl
Robot+Gripper+MG90S+/images/tiny_thumb_gripper_base_v2.stl
Robot+Gripper+MG90S+/images/small_thumb_MG-90s_servo.stl
Robot+Gripper+MG90S+/images/small_thumb_gripper_rack-gear_v3.stl
Robot+Gripper+MG90S+/images/large_preview_gear.stl
Robot+Gripper+MG90S+/images/small_display_shelfie5_20191021-51-hld2st.stl
Robot+Gripper+MG90S+/images/medium_preview_gripper_rack-gear_v3.stl
Robot+Gripper+MG90S+/images/tiny_preview_gear.stl
Robot+Gripper+MG90S+/images/tiny_thumb_gear.stl
Robot+Gripper+MG90S+/images/large_display_dazzling_bigery.stl
Robot+Gripper+MG90S+/images/card_preview_MG-90s_servo.stl
Robot+Gripper+MG90S+/images/card_preview_gear.stl
Robot+Gripper+MG90S+/images/card_preview_gripper_rack-gear_v2.stl
Robot+Gripper+MG90S+/images/large_preview_gripper_rack-gear_v2.stl
Robot+Gripper+MG90S+/images/large_thumb_gripper_rack-gear_v2.stl
Robot+Gripper+MG90S+/images/medium_preview_gripper_rack-gear_v2.stl
Robot+Gripper+MG90S+/images/medium_thumb_gripper_rack-gear_v2.stl
Robot+Gripper+MG90S+/images/small_preview_gripper_rack-gear_v2.stl
Robot+Gripper+MG90S+/images/small_thumb_gripper_rack-gear_v2.stl
Robot+Gripper+MG90S+/images/tiny_preview_gripper_rack-gear_v2.stl
Robot+Gripper+MG90S+/images/tiny_thumb_gripper_rack-gear_v2.stl
Robot+Gripper+MG90S+/images/tinycard_preview_gripper_rack-gear_v2.stl
dan robot arm/arm-joint-3/arm-joint-3.stl
dan robot arm/untitled.blend
rbrmclx.blend
