Ahkdel/WirelessRobotArm/(list of files, drawings)

Other design files:
Circuits/receiver circuit.pdsprj
Circuits/transmitter circuit.pdsprj
RFmodule.pdsprj
