Ahkdel/WirelessRobotArm/(commit log)

2021-05-13 Changes of schematics
    [receiver circuit.pdsprj, transmitter circuit.pdsprj]
2021-05-13 Deleted more files
    [EBA_01.00.001.STL, EBA_01.00.002_vertical_drive_arm.STL, EBA_01.00.003_link.STL, EBA_01.00.004_forward_drive_arm.STL, EBA_01.00.005_horizontal_arm.STL, EBA_01.00.006_triangular_link.STL, EBA_01.00.009_servo_plate.STL, EBA_01.00.010_basement.STL]
